VODINHQUOC/Line-Follower-Robot-with-CAN-System/README.md

# Line Follower Robot with CAN System
 Thesis of Mechatronic
