VODINHQUOC/Line-Follower-Robot-with-CAN-System/Nhom5_4 bản vẽ CAD vs PDF/PDF/A0_newest_LuaChonPhuongAn.pdf

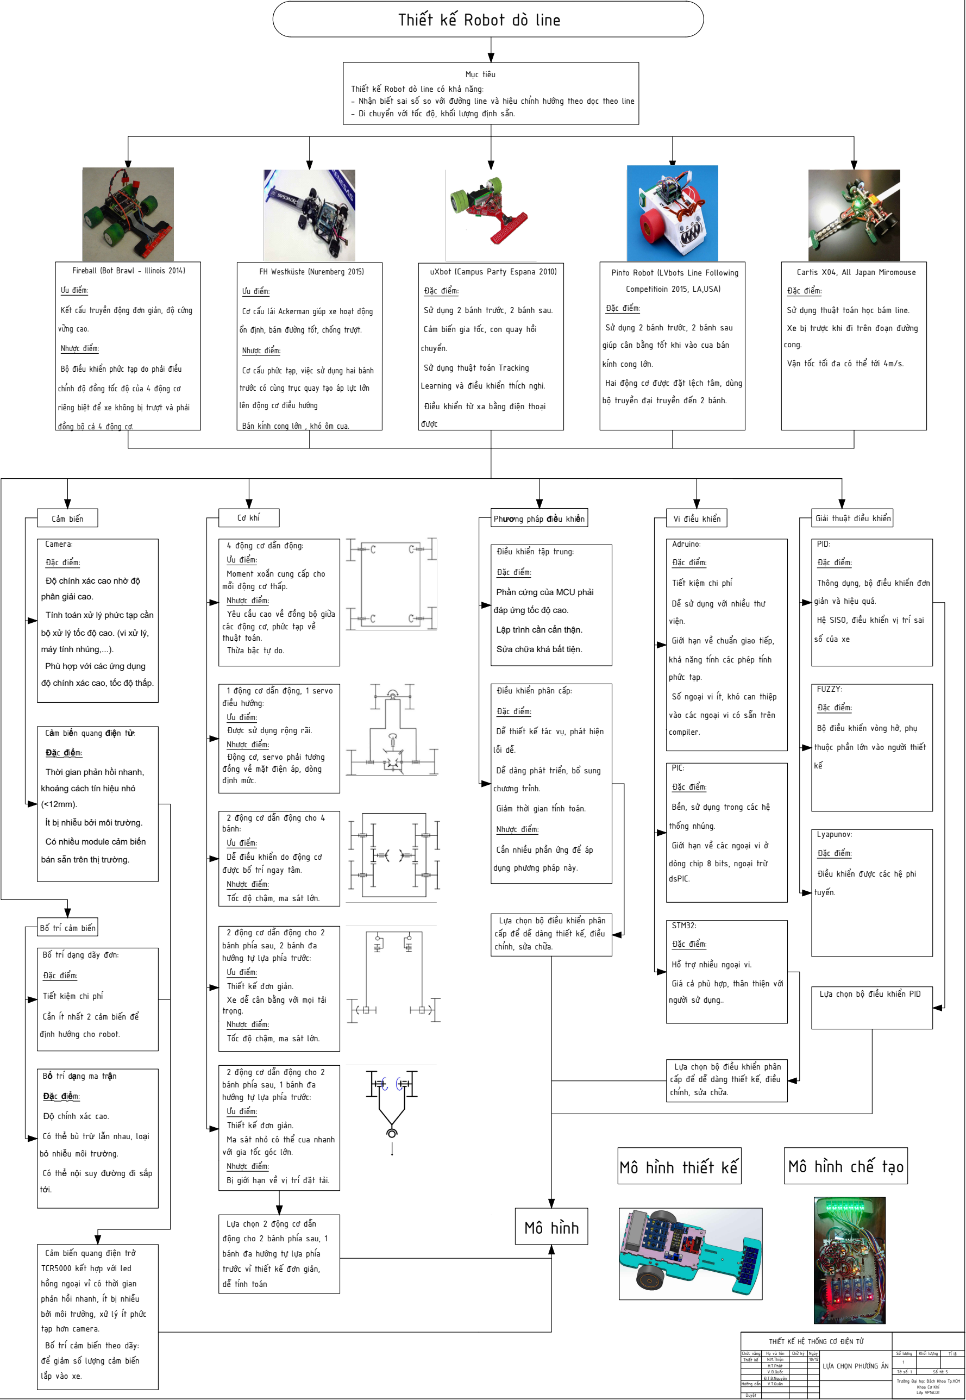
[picture p1: figure]
Thiết kế Robot dò line; Mục tiêu; Thiết kế Robot dò line cw khả nng:; LA CHN PHƯNG ÃN; Số lượng; Thiết kế; N.M.Thiện; Hướng dn; V.T.2uân; Duyệt; H và tên; Ngày; ,hối lượng; THIT , H THNG C ĐIN T; V.Đ.2uốc; H.T.Phát; Trường Đại hc Bách ,hoa Tp.HCM ,hoa Cơ ,hí; Lớp VP1CDT; Fireball (Bot Brawl - Illinois 2014); Ưu điểm:; ,ết cấu truyền động đơn giản, độ cng; vng cao.; Nhược điểm:; Bộ điều khiển phc tạp do phải điều; chnh độ đng tốc độ của 4 động cơ; riêng biệt để xe không bị trượt và phải; đng bộ cả 4 động cơ.; FH Westküste (Nuremberg 2015); Cơ cấu lái Ackerman gi|p xe hoạt động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

- Nhận biết sai số so với đường line và hiệu chnh hướng theo dc theo line
- Di chuyển với tốc độ, khối lượng định sn.
Mô hình | Mô hình thiết kế | Mô hình chế tạo
