VODINHQUOC/Line-Follower-Robot-with-CAN-System/LineFollowerRobot/TCRT5000mod.SLDPRT

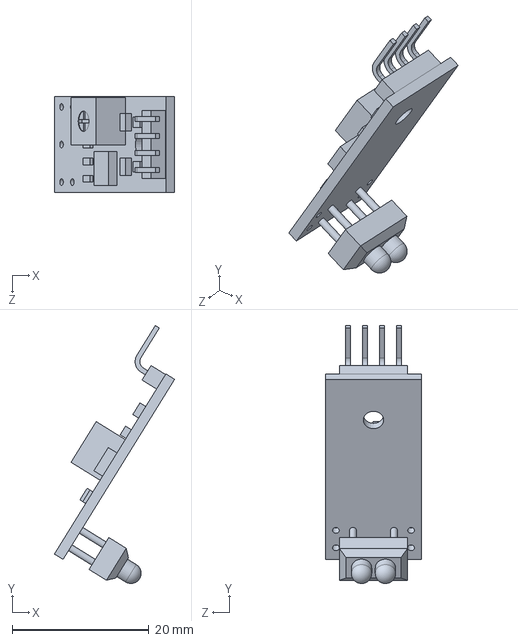
[picture p2: CAD file, 2021-02-19]
LineFollowerRobot/TCRT5000mod.SLDPRT
17.6 x 37.8 x 14.0 mm
