VODINHQUOC/Line-Follower-Robot-with-CAN-System/LineFollowerRobot/Base-3.SLDPRT

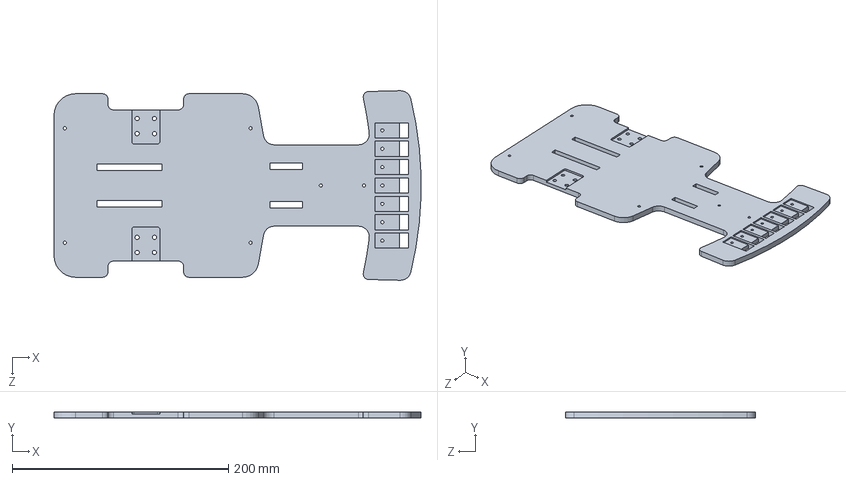
[picture p3: CAD file, 2021-02-19]
LineFollowerRobot/Base-3.SLDPRT
339.8 x 6.00 x 175.6 mm
