VODINHQUOC/Line-Follower-Robot-with-CAN-System/LineFollowerRobot/25mm DC Geared Motor Mounting Bracket.SLDPRT

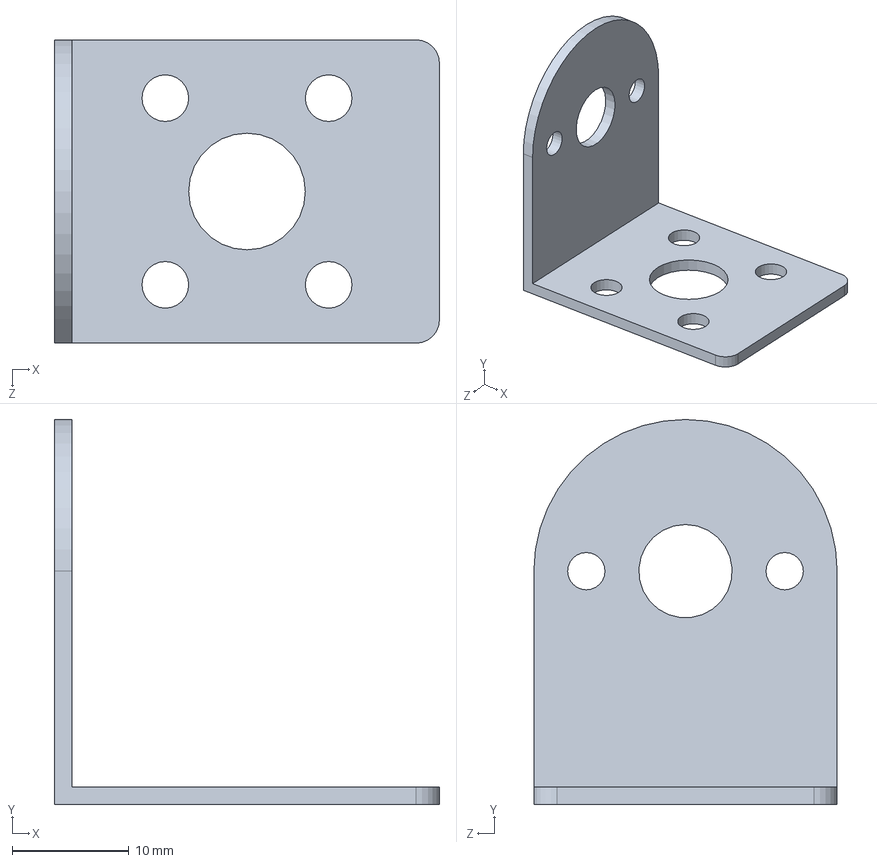
[picture p4: CAD file, 2021-02-19]
LineFollowerRobot/25mm DC Geared Motor Mounting Bracket.SLDPRT
33.0 x 33.0 x 26.0 mm
