VODINHQUOC/Line-Follower-Robot-with-CAN-System/LineFollowerRobot/Wheels-65mm.SLDPRT

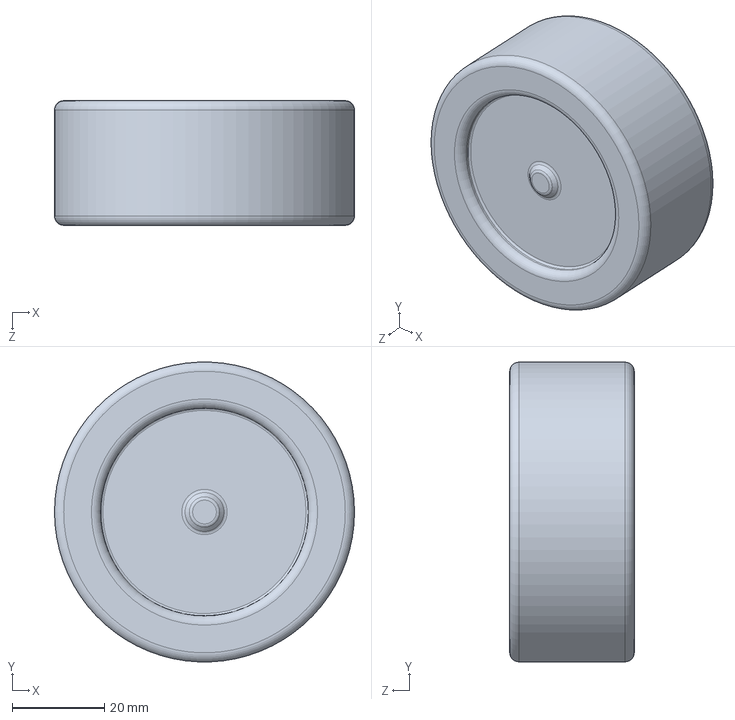
[picture p5: CAD file, 2021-02-19]
LineFollowerRobot/Wheels-65mm.SLDPRT
65.0 x 64.9 x 27.0 mm
