VODINHQUOC/Line-Follower-Robot-with-CAN-System/LineFollowerRobot/Trudong-20mm-caicai.SLDPRT

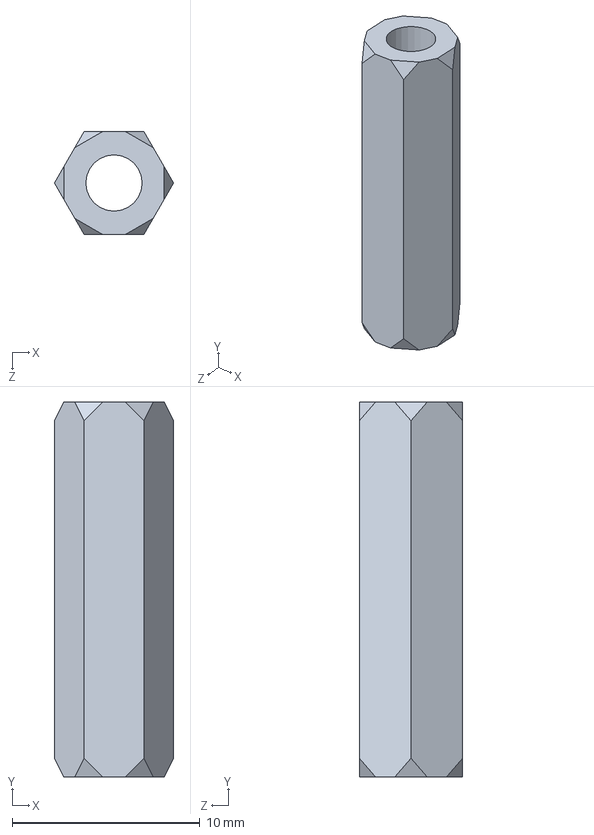
[picture p6: CAD file, 2021-02-19]
LineFollowerRobot/Trudong-20mm-caicai.SLDPRT
6.36 x 20.0 x 5.51 mm
