VODINHQUOC/Line-Follower-Robot-with-CAN-System/LineFollowerRobot/Mat-trau-40x20mm.SLDPRT

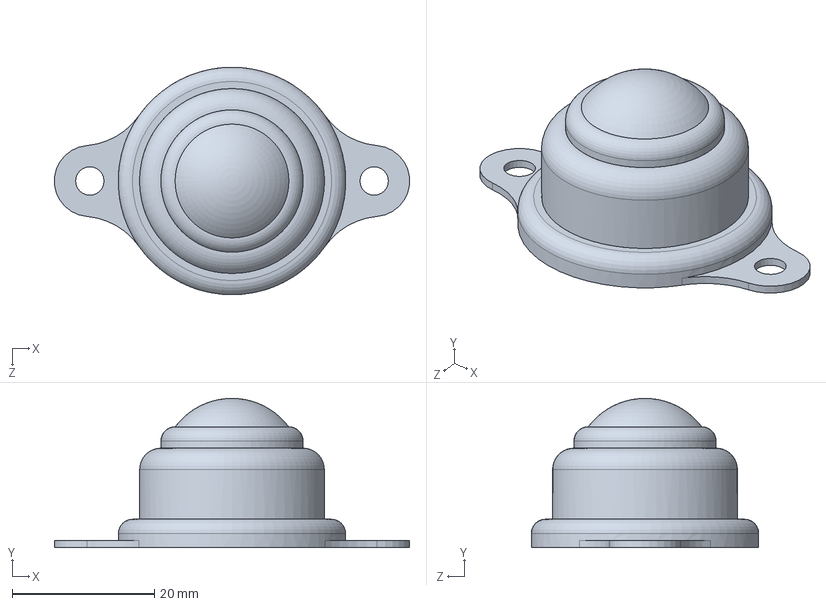
[picture p7: CAD file, 2021-02-19]
LineFollowerRobot/Mat-trau-40x20mm.SLDPRT
49.9 x 21.0 x 32.0 mm
