VODINHQUOC/Line-Follower-Robot-with-CAN-System/LineFollowerRobot/m4.SLDPRT

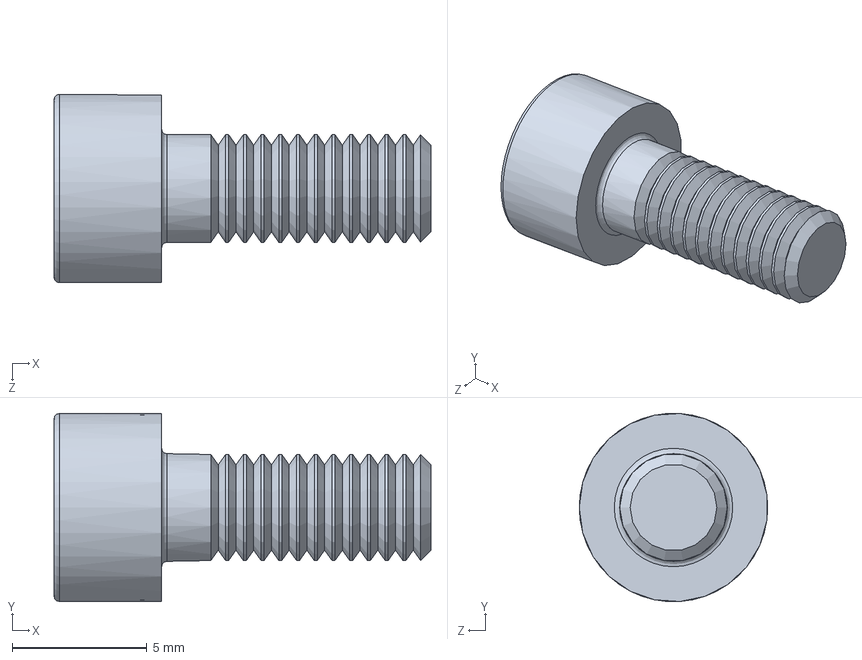
[picture p8: CAD file, 2021-02-19]
LineFollowerRobot/m4.SLDPRT
14.0 x 6.98 x 7.00 mm
