VODINHQUOC/Line-Follower-Robot-with-CAN-System/LineFollowerRobot/m3.SLDPRT

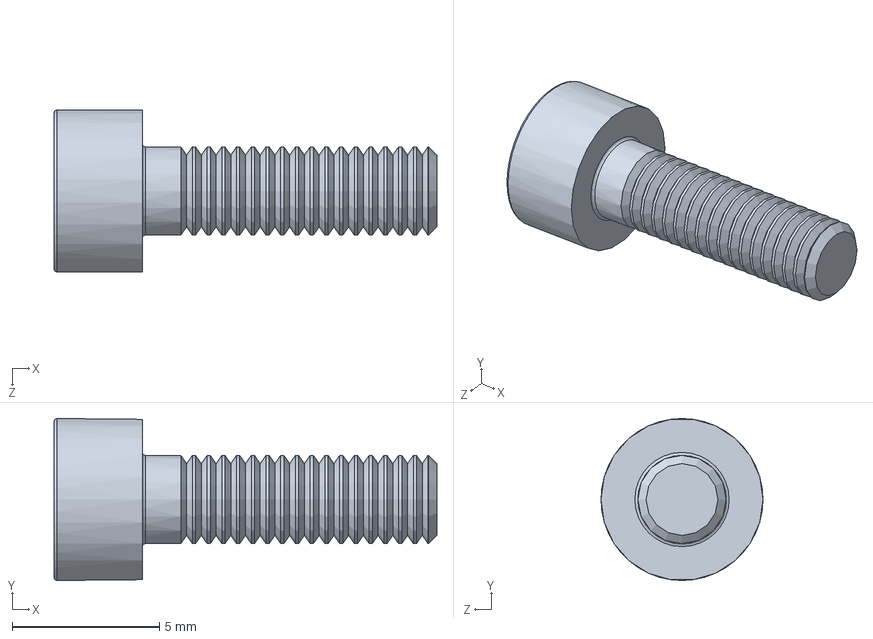
[picture p9: CAD file, 2021-02-19]
LineFollowerRobot/m3.SLDPRT
13.0 x 5.50 x 5.50 mm
