VODINHQUOC/Line-Follower-Robot-with-CAN-System/LineFollowerRobot/M3 Nut.SLDPRT

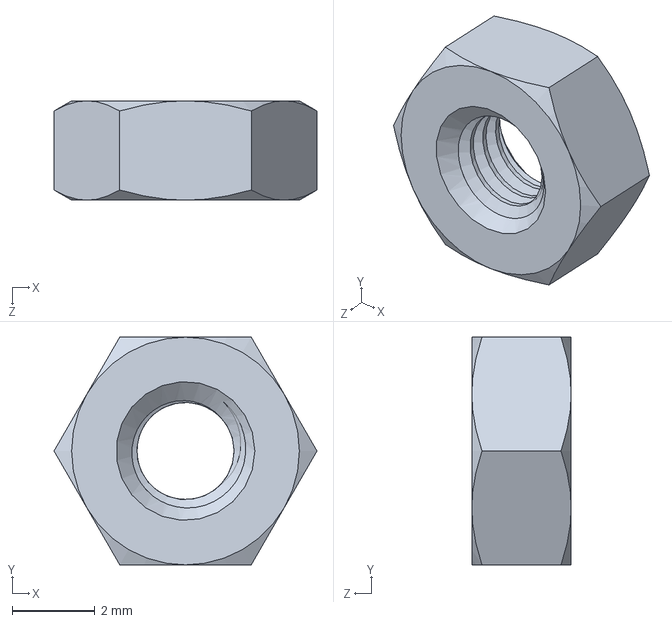
[picture p10: CAD file, 2021-02-19]
LineFollowerRobot/M3 Nut.SLDPRT
6.35 x 5.50 x 2.40 mm
