VODINHQUOC/Line-Follower-Robot-with-CAN-System/LineFollowerRobot/M4 Nut.SLDPRT

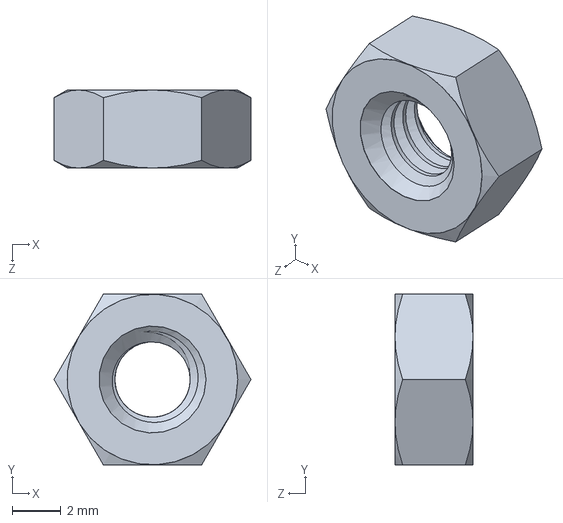
[picture p11: CAD file, 2021-02-19]
LineFollowerRobot/M4 Nut.SLDPRT
8.08 x 7.00 x 3.22 mm
