VODINHQUOC/Line-Follower-Robot-with-CAN-System/(list of files, cad)

Other CAD files:
Nhom5_4 bản vẽ CAD vs PDF/CAD/Line_BanVeCoKhi.dwg
Nhom5_4 bản vẽ CAD vs PDF/CAD/line_BanVeGiaiThuat.dwg
Nhom5_4 bản vẽ CAD vs PDF/CAD/line_BanVeluachonphuongan.dwg
Nhom5_4 bản vẽ CAD vs PDF/CAD/line_BanVeDien.dwg
