VODINHQUOC/Line-Follower-Robot-with-CAN-System/Nhom5_4 bản vẽ CAD vs PDF/PDF/A0_newest_BanGiaithuat.pdf

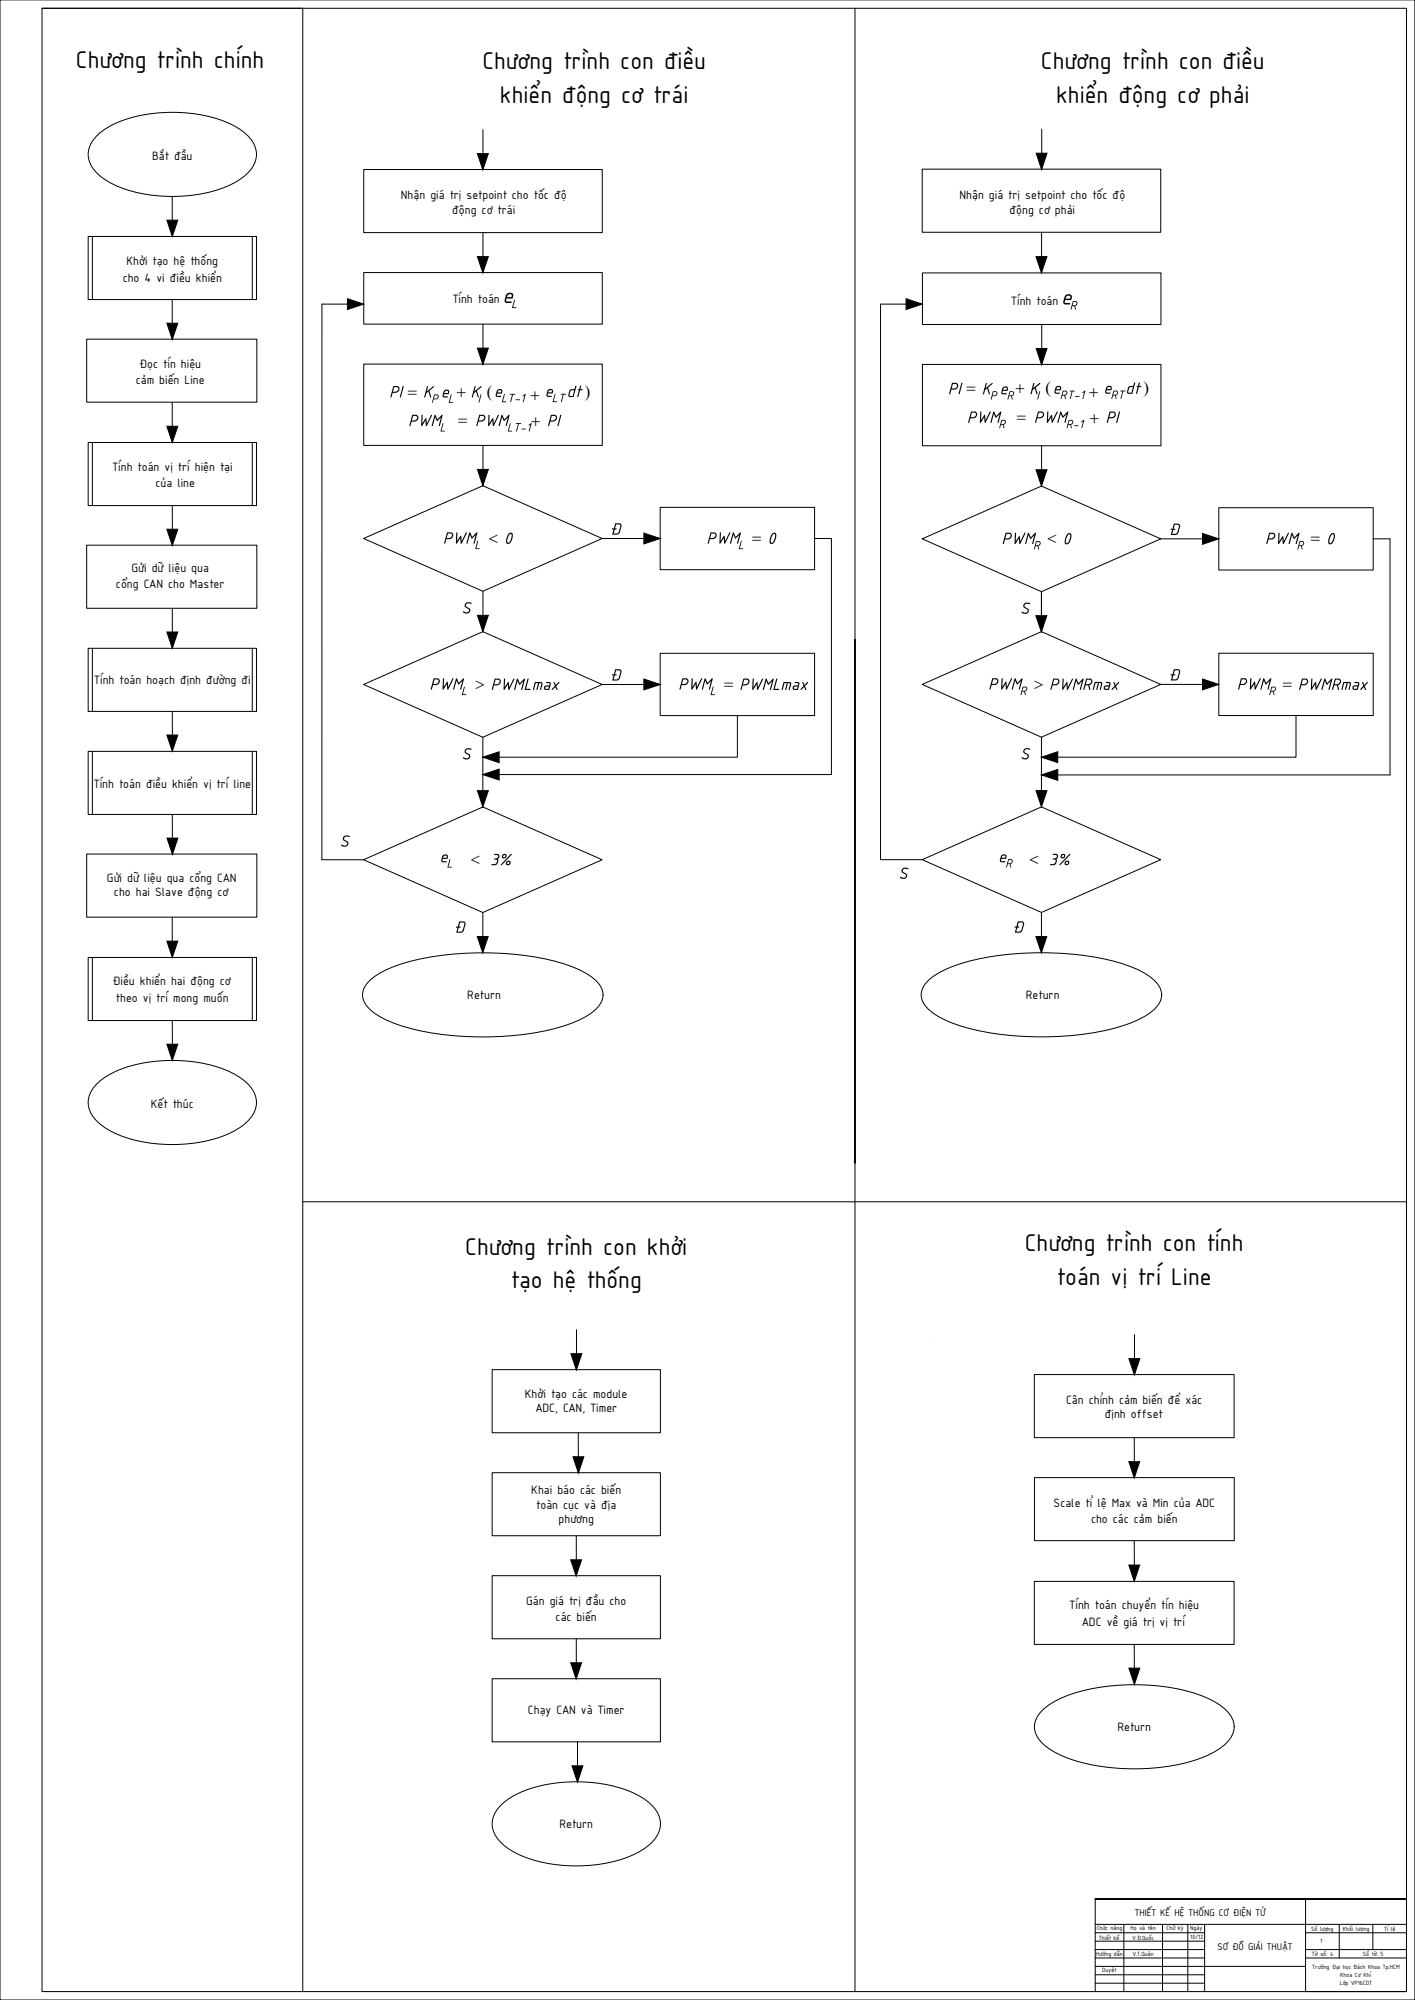
[picture p12: page 1]
Tính toán; Bắt đầu; của line; Kết thúc; PWM =; Chức năng; Số lượng; Thiết kế; Hướng dẫn; Chữ ký; Ngày; Khối lượng; PWMLT-1+ PI; PWML < 0; PWML >; = PWMLmax; Tính toáneR; PWMR-1 + PI; PWMR < 0; PWMR >; = PWMRmax; định offset

Chương trình chính

Chương trình con điều
khiển động cơ trái

khiển động cơ phải

Nhận giá trị setpoint cho tốc độ

động cơ trái

động cơ phải

Khởi tạo hệ thống
cho 4 vi điều khiển

Đọc tín hiệu
cảm biến Line

Tính toán vị trí hiện tại

Gửi dữ liệu qua
cổng CAN cho Master

Tính toán hoạch định đường đi

Tính toán điều khiển vị trí line

Gửi dữ liệu qua cổng CAN
cho hai Slave động cơ

Điều khiển hai động cơ
theo vị trí mong muốn

Chương trình con tính
toán vị trí Line

Chương trình con khởi
tạo hệ thống

Khởi tạo các module
ADC, CAN, Timer

Cân chỉnh cảm biến để xác

Khai báo các biến
toàn cục và địa
phương

Scale tỉ lệ Max và Min của ADC

cho các cảm biến

Gán giá trị đầu cho
các biến

Tính toán chuyển tín hiệu
ADC về giá trị vị trí

Chạy CAN và Timer

THIẾT KẾ HỆ THỐNG CƠ ĐIỆN TỬ

Họ và tên
V.Đ.Quốc

SƠ ĐỒ GIẢI THUẬT

Trường Đại học Bách Khoa Tp.HCM

Khoa Cơ Khí
Lớp VP16CDT
