VODINHQUOC/Line-Follower-Robot-with-CAN-System/Nhom5_4 bản vẽ CAD vs PDF/PDF/A0_newest_BanGiaithuat_so2.pdf

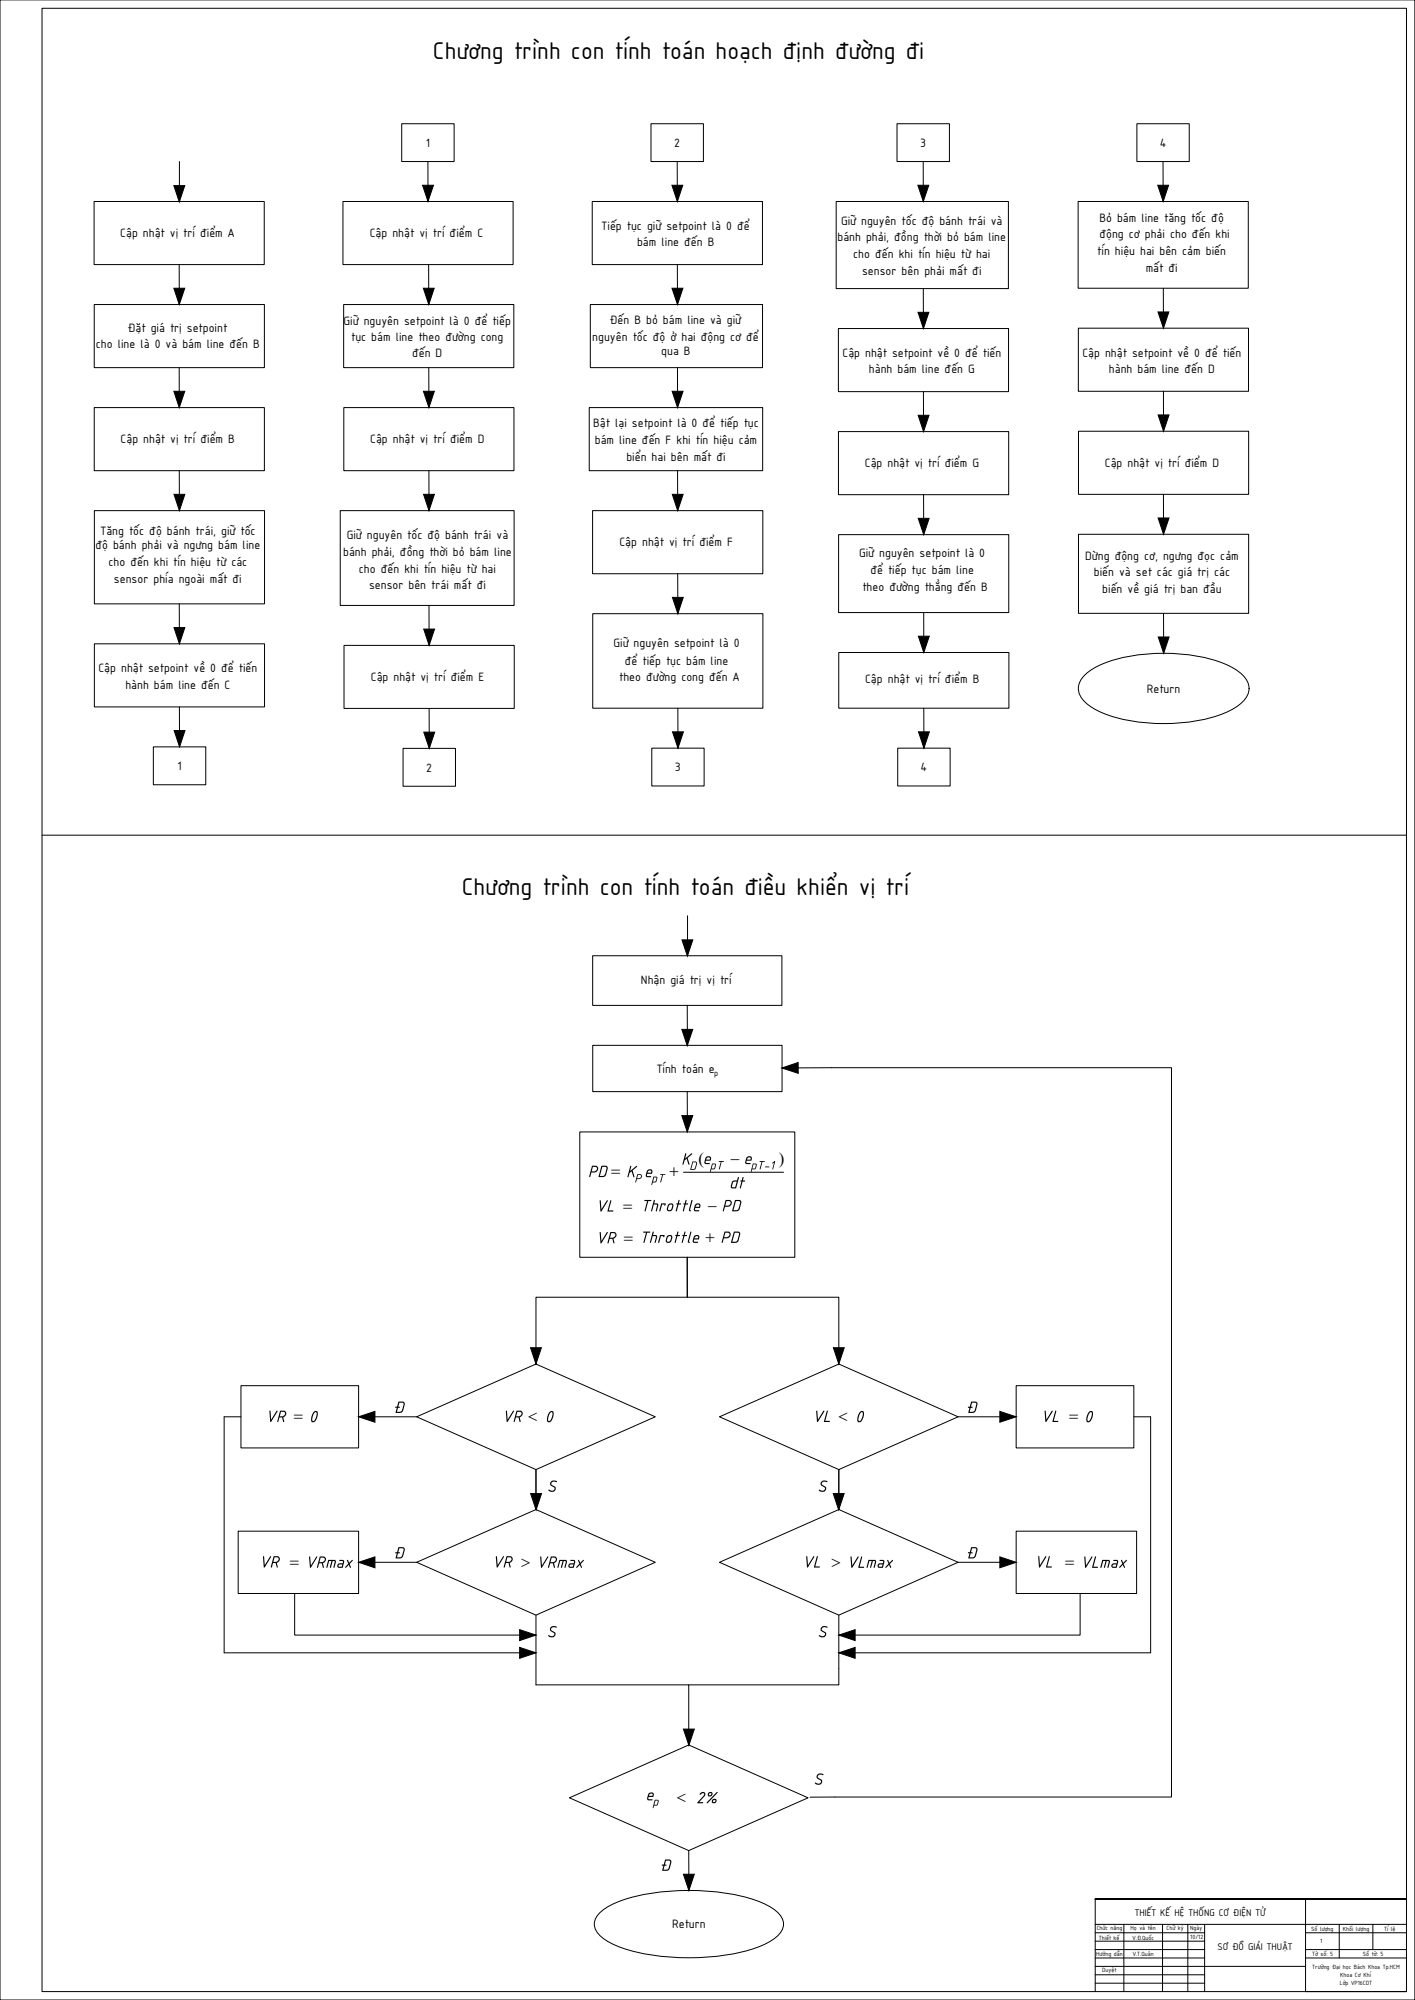
[picture p13: page 1]
Throttle; Chức năng; Số lượng; Thiết kế; Hướng dẫn; Chữ ký; Ngày; Khối lượng; đến D; qua B; mất đi; VLmax; VL = VLmax; VR = VRmax; VR > VRmax

Chương trình con tính toán hoạch định đường đi

Bỏ bám line tăng tốc độ
động cơ phải cho đến khi
tín hiệu hai bên cảm biến

Giữ nguyên tốc độ bánh trái và
bánh phải, đồng thời bỏ bám line
cho đến khi tín hiệu từ hai
sensor bên phải mất đi

Tiếp tục giữ setpoint là 0 để

Cập nhật vị trí điểm A

Cập nhật vị trí điểm C

bám line đến B

Giữ nguyên setpoint là 0 để tiếp
tục bám line theo đường cong

Đến B bỏ bám line và giữ
nguyên tốc độ ở hai động cơ để

Đặt giá trị setpoint
cho line là 0 và bám line đến B

Cập nhật setpoint về 0 để tiến
hành bám line đến G

hành bám line đến D

Bật lại setpoint là 0 để tiếp tục
bám line đến F khi tín hiệu cảm
biển hai bên mất đi

Cập nhật vị trí điểm B

Cập nhật vị trí điểm D

Cập nhật vị trí điểm G

Tăng tốc độ bánh trái, giữ tốc
độ bánh phải và ngưng bám line
cho đến khi tín hiệu từ các
sensor phía ngoài mất đi

sensor bên trái mất đi

Cập nhật vị trí điểm F

Giữ nguyên setpoint là 0
để tiếp tục bám line
theo đường thẳng đến B

Dừng động cơ, ngưng đọc cảm
biến và set các giá trị các
biến về giá trị ban đầu

theo đường cong đến A

hành bám line đến C

Cập nhật vị trí điểm E

Chương trình con tính toán điều khiển vị trí

Nhận giá trị vị trí

Tính toán ep

THIẾT KẾ HỆ THỐNG CƠ ĐIỆN TỬ

Họ và tên
V.Đ.Quốc

SƠ ĐỒ GIẢI THUẬT

Trường Đại học Bách Khoa Tp.HCM

Khoa Cơ Khí
Lớp VP16CDT
