VODINHQUOC/Line-Follower-Robot-with-CAN-System/Nhom5_4 bản vẽ CAD vs PDF/PDF/A0_newest_BanVeDien.pdf

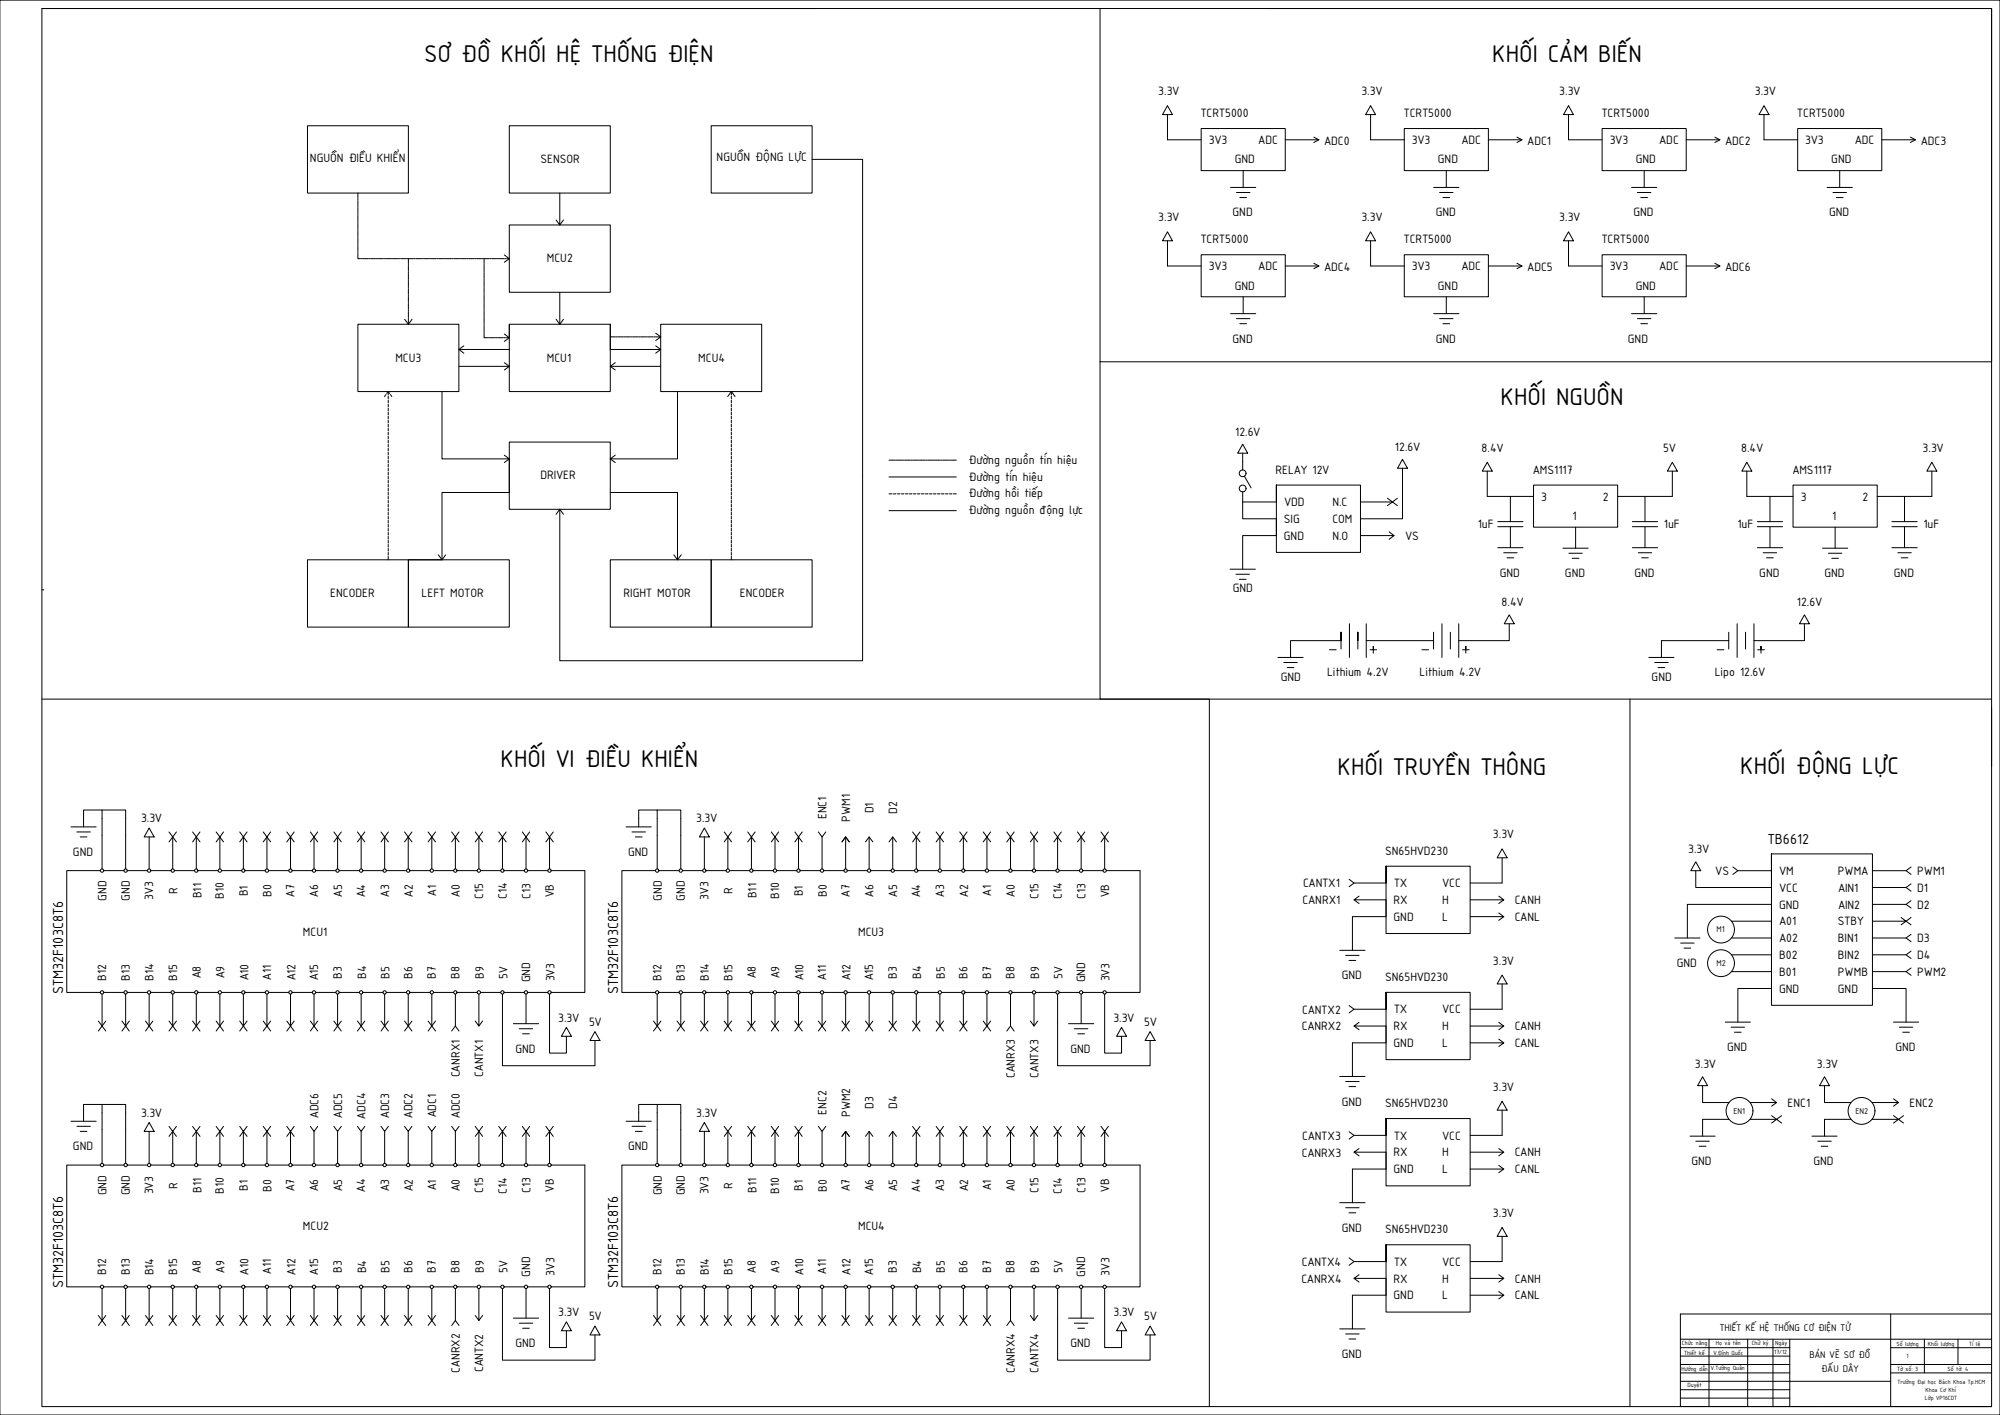
[picture p14: page 1]
Hướng dẫn; Số lượng; Khối lượng; Số tờ: 4 KHỐI VI ĐIỀU KHIỂN; KHỐI NGUỒN 3; GND AMS1117GND 8.4V; 5V GND 1uF; ADC GND; ADC0 TCRT5000 GND 3.3V; ADC1; ADC GND 3V3; ADC5; ADC4; 17/12 V.Tường Quân THIẾT KẾ HỆ THỐNG CƠ ĐIỆN TỬ; Lớp VP16CDT VMVCC GND A01 A02 B02 B01 GND; PWMA AIN1 AIN2 STBY BIN1 BIN2 PWMB GND 3.3V; GND M1 M2; GNDPWM1 D1 D2D3D4PWM2 3V3; ADC3; CANRX1 GND; CANTX1 GND; 3V3 GND; CANRX2 GND; 3V3 3.3V 5V GND; CANRX3 GND; 3V3 GND 3.3V

STM32F103C8T6 ADC2 ADC6 SENSOR MCU2 MCU3 MCU1 MCU4 ENCODER LEFT MOTOR ENCODER DRIVER SƠ ĐỒ KHỐI HỆ THỐNG ĐIỆN NGUỒN ĐIỀU KHIỂN NGUỒN ĐỘNG LỰC RIGHT MOTOR Đường nguồn tín hiệu Đường tín hiệu Đường hồi tiếp Đường nguồn động lực GND 8.4V Lithium 4.2V Lithium 4.2V GND 12.6V Lipo 12.6V MCU1 MCU2 MCU4 MCU3

KHỐI CẢM BIẾN

D2 EN1 EN2 GND 3.3V 3.3V ENC1 GND ENC2 VDD SIG GND N.C COM N.O 12.6V 12.6VVS VS 3.3V 3.3V 3.3V TXRXGND VCC HL RELAY 12V 3.3VCANH CANL CANTX1 CANRX1GND TXRXGND VCC HL SN65HVD230 3.3VCANH CANL CANTX2 CANRX2GND TXRXGND VCC HL 3.3VCANH CANL CANTX3 CANRX3GND TXRXGND VCC HL 3.3VCANH CANL CANTX4 CANRX4GND KHỐI TRUYỀN THÔNG GND TB6612 SN65HVD230 SN65HVD230 SN65HVD230GND 3.3V GND 3.3V GND 3.3V GND 3.3V GND 3.3V GND 3.3V 3 2 1 GND AMS1117GND 8.4V 3.3V GND 1uF 1uF TCRT5000 TCRT5000 TCRT5000 TCRT5000 TCRT5000 TCRT5000 3.3V 5V 3.3V 5V 3.3V 5V

KHỐI ĐỘNG LỰC

Chức năng | Họ và tên | Chữ ký | Ngày | BẢN VẼ SƠ ĐỒ ĐẤU DÂY
Thiết kế | V.Đình Quốc

Trường Đại học Bách Khoa Tp.HCM

Khoa Cơ Khí
