VODINHQUOC/Line-Follower-Robot-with-CAN-System/Nhom5_4 bản vẽ CAD vs PDF/PDF/A0_newest_BanveCoKhi.pdf

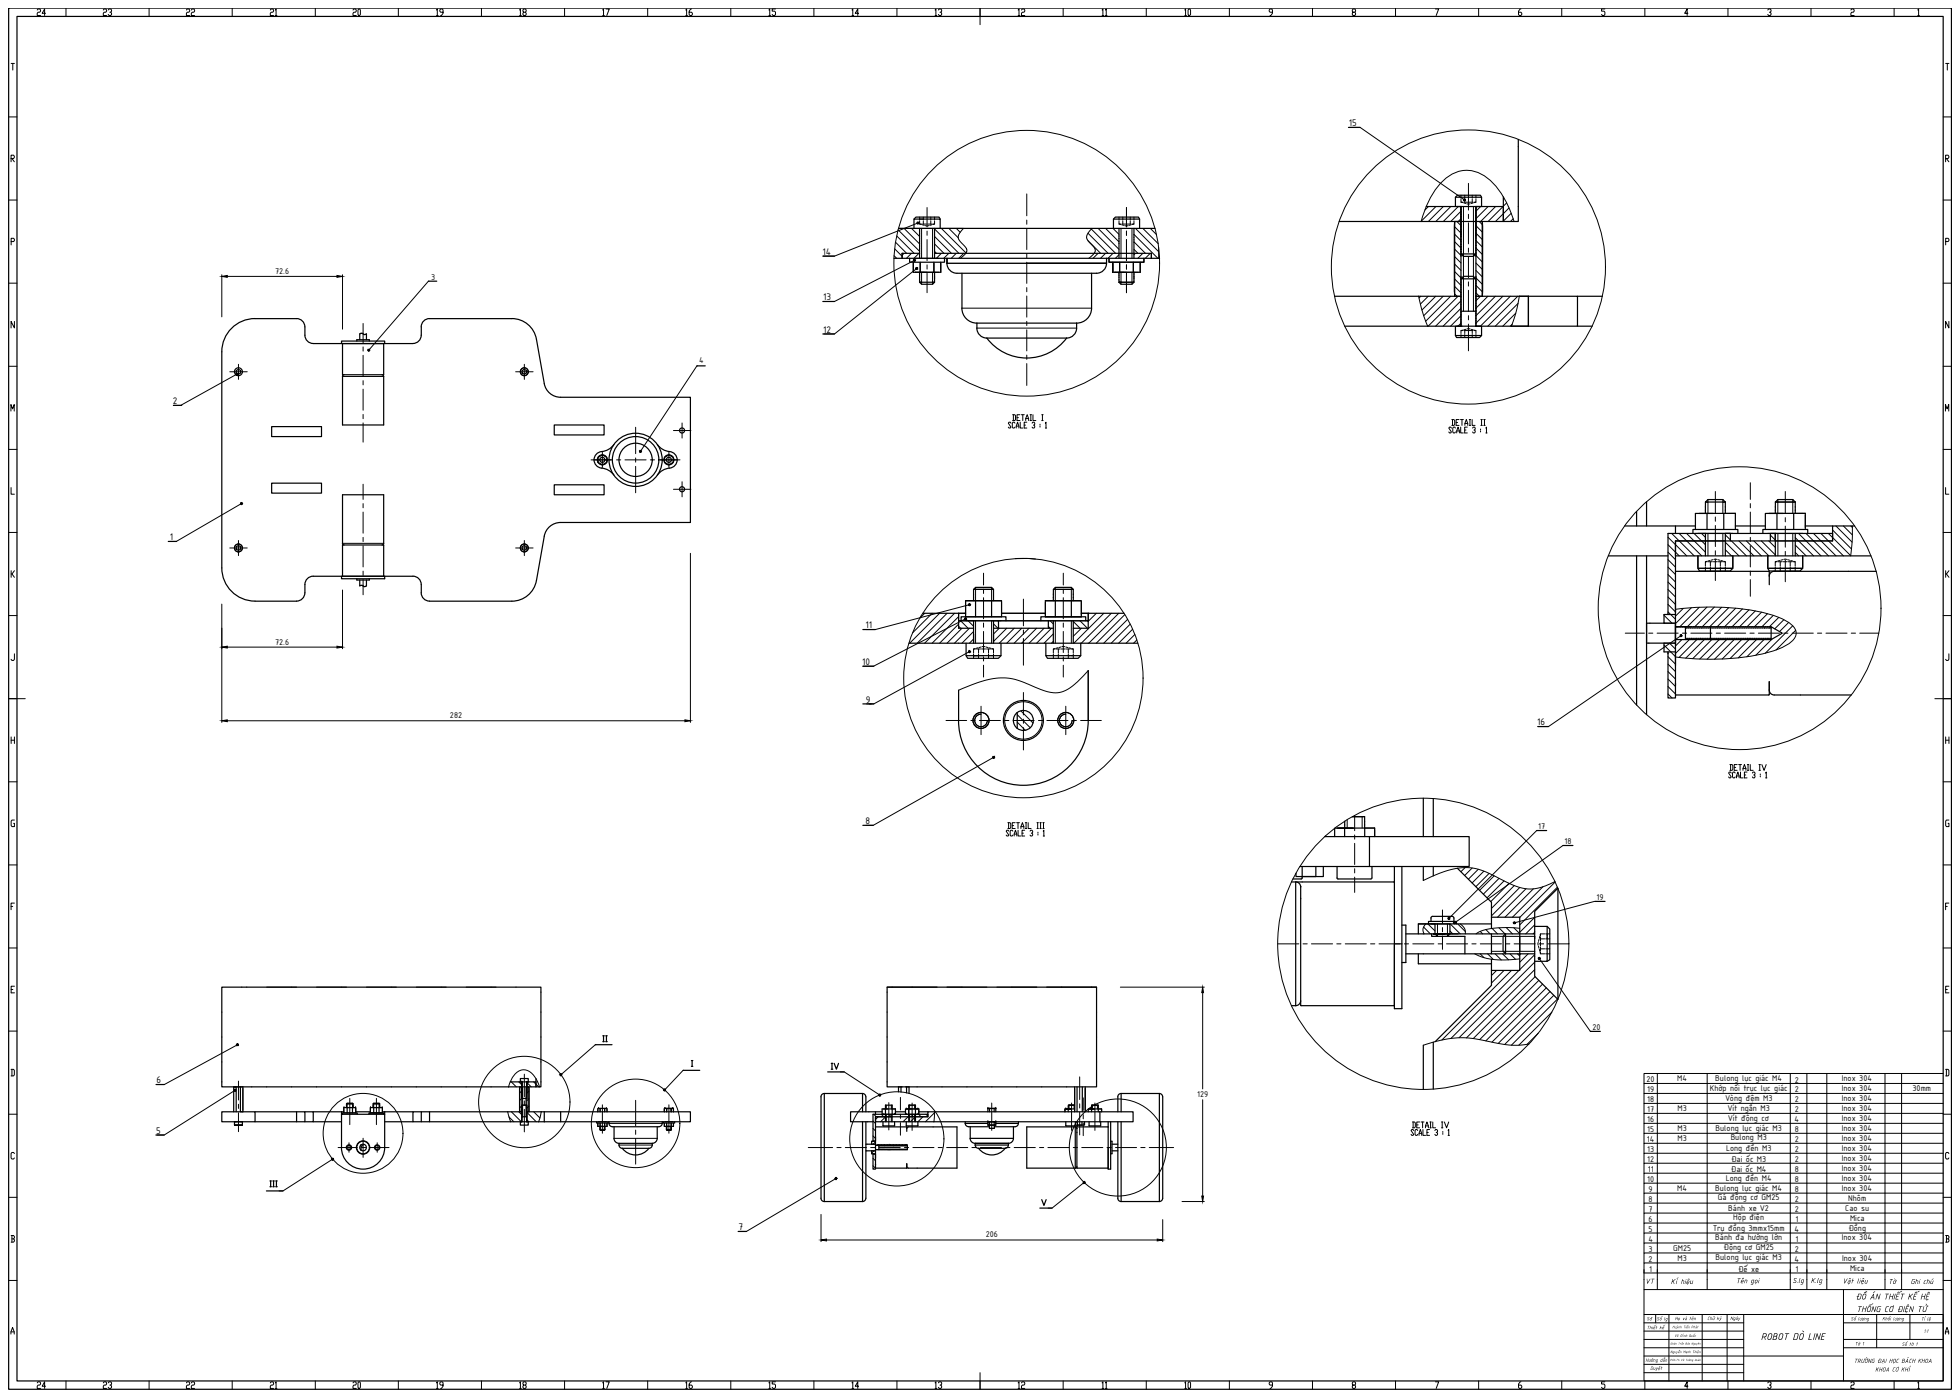
[picture p15: page 1]
TRƯỜNG ĐẠI HỌC BÁCH KHOA; Tỉ lệ 1:1 Số lượng; Khối lượng ROBOT DÒ LINE Sđ; Họ và tên; Chữ ký; Ngày Thiết kế; Huỳnh Tiến Phát Võ Đình Quốc; THỐNG CƠ ĐIỆN TỬ VT; Kí hiệu; Tên gọi; Vật liệu; Ghi chú 12; Mica Bulong lục giác M3 Động cơ GM25 Bánh đa hướng lớn Trụ đồng 3mmx15mm Hộp điện Bánh xe V2 Gá động cơ GM25 Bulong lục giác M4 Long đền M4 Đai ốc M4 Vít động cơ; Inox 304 Đồng Mica Cao su Nhôm GM25; Inox 304 M4; Inox 304 Inox 304 Inox 304 Đai ốc M3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

ĐỒ ÁN THIẾT KẾ HỆ

Nguyễn Mạnh Thiện | KHOA CƠ KHÍ Tờ 1 Số tờ 1
Đoàn Trần Bảo Nguyên

Hướng dẫn | PGS.TS Võ Tường Quân

Duyệt
