VODINHQUOC/Line-Follower-Robot-with-CAN-System/Nhom5_CODE STM32F103/READ TCR/CODE/ReadTCR.ioc

Mcu.UserName=STM32F103C8Tx
PA0-WKUP.Signal=ADCx_IN0
PA1.Signal=ADCx_IN1
PA10.Signal=GPIO_Input
PA11.Signal=GPIO_Input
PA12.Signal=GPIO_Input
PA13.Signal=SYS_JTMS-SWDIO
PA14.Signal=SYS_JTCK-SWCLK
PA15.Signal=GPIO_Input
PA2.Signal=ADCx_IN2
PA3.Signal=ADCx_IN3
PA4.Signal=ADCx_IN4
PA5.Signal=ADCx_IN5
PA6.Signal=ADCx_IN6
PA8.Signal=GPIO_Input
PA9.Signal=GPIO_Input
PB15.Signal=GPIO_Input
PB8.Signal=CAN_RX
PB9.Signal=CAN_TX
PC13-TAMPER-RTC.Signal=GPIO_Output
PD0-OSC_IN.Signal=RCC_OSC_IN
PD1-OSC_OUT.Signal=RCC_OSC_OUT
